YupHio/LEaD_Design/README.md

# Wiki Page
View our Wiki page at this URL: http://mindworks.shoutwiki.com/wiki/Wireless_Tower_of_Lights

# LEaD_Design
Wireless Tower Lights Project for Senior Capstone Design

### Teammates:
- Adrian Beehner
- Kevin Dorscher
- Andrew Butler
- Paul Martin
