YupHio/LEaD_Design/Doc/Meetings/Meeting_Notes/3-23 Meeting Notes.docx

3/23/18 Client Meeting Notes

Meeting started at 3:49, all team members except Adrian present. Adrian had an emergency and wouldn’t be available until 5 at the earliest.

What number of light bars are required? Prof. Rinker doesn’t care, he suggests that we have enough to put on a little show at expo. At least 4. Volunteers could manufacture the rest after this semester.

Rinker suggests adding a resistor to each set of LEDs, rather than having one for both sets in parallel. Another option would be to adjust the existing resistor value, but that will tie the circuits together meaning that a failure would affect all the other LEDs, rather than just the others in the string. That might not cause damage though, we should test a breech in one side of the circuit.

Wire management: trim what we have, minimize slack, use electrical tape to keep nice and out of the way.

Rinker’s going to send us the Goofy Glasses code for the PC and the Arduino once he can find it on his PC. We have battery chargers, receivers, and resistors. We just need the ZIF socket to program Arduino chips and then we should be good to go. Rinker will be putting that in his mailbox sometime this weekend.

Meeting ended at 4:30
