YupHio/LEaD_Design/Doc/Snapshot_Day_3/Documentation of Design-Proof of Design.pdf

## Documentation of Design

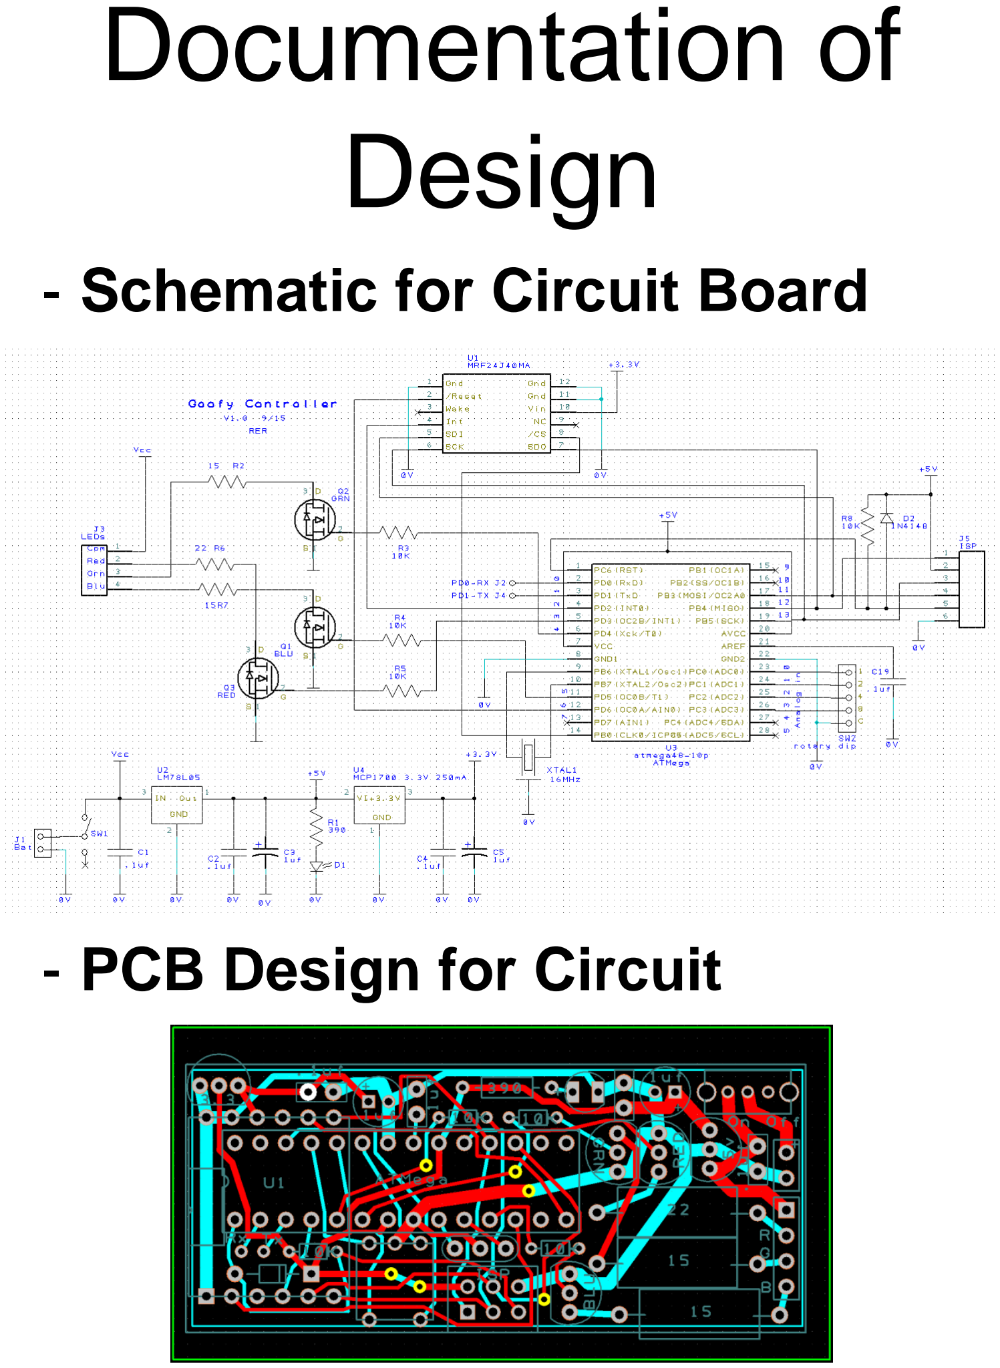
[picture p35: page 1]

- Schematic for Circuit Board
- PCB Design for Circuit

- LightBar
- Lightbar designed similar to original Tower of Lights one

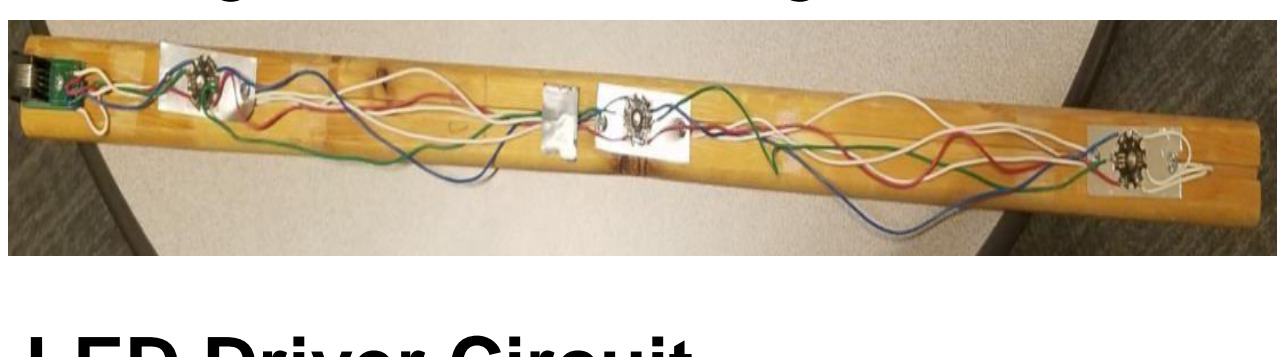
[picture p36: figure]

- LED Driver Circuit
- Similar to Goofy Glasses circuit (top), ours (bottom)

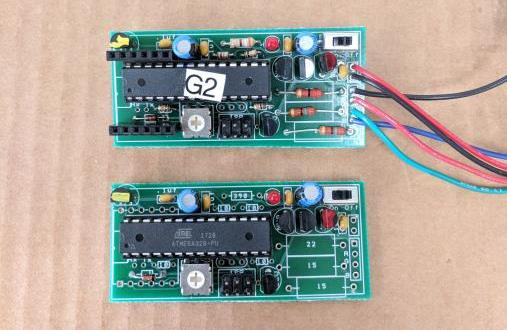
[picture p37: figure]

- Towerplayer program
- Modifed towerarduino.ino, towerplayer.cpp

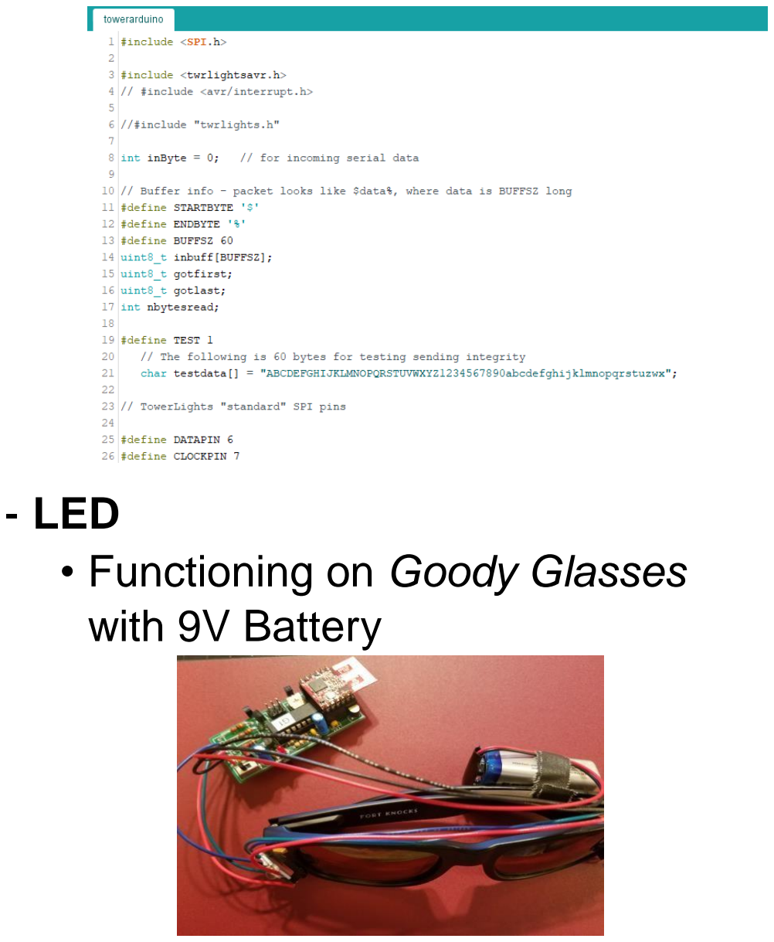
[picture p38: page 3]

- LED
- Functioning on Goody Glasses with 9V Battery

Data Sheets:
- Xbee Transmitter

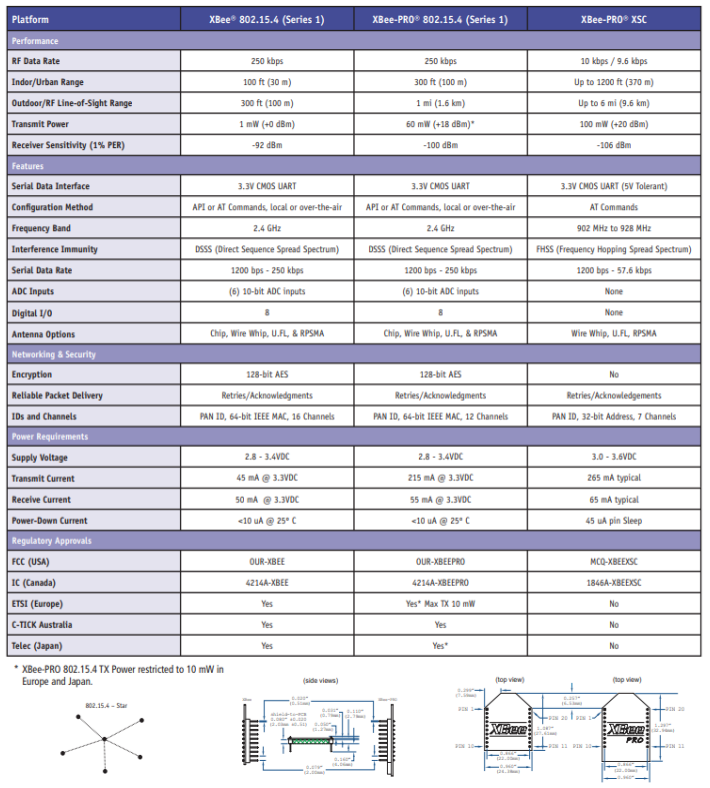
[picture p39: figure]

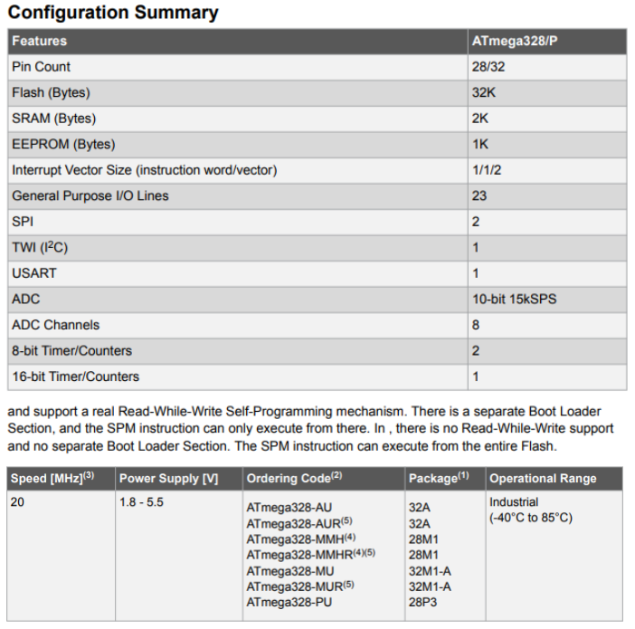
[picture p40: figure]

- Atmega 328P

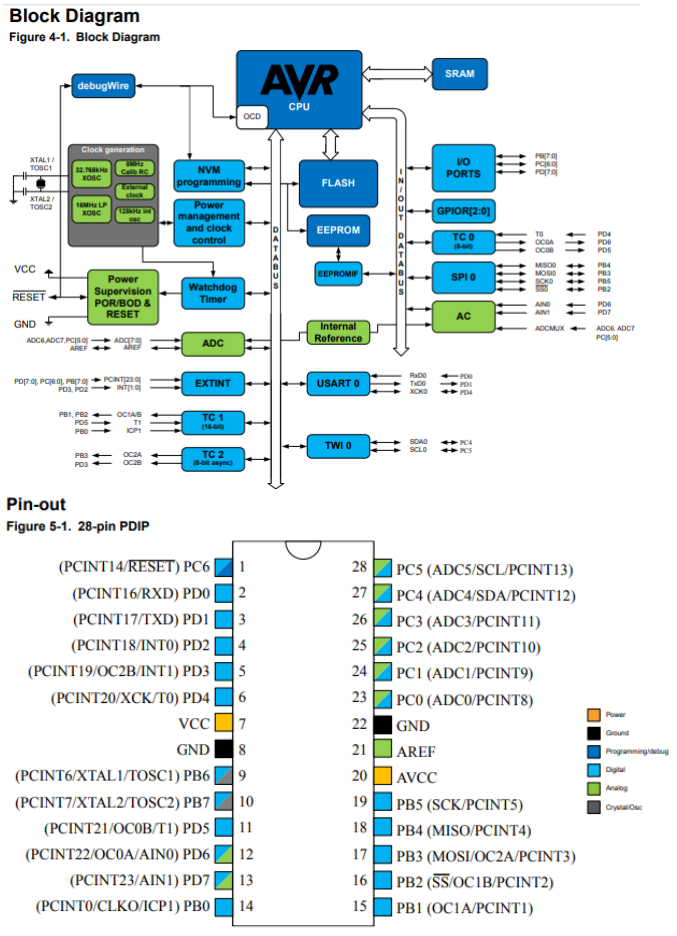
[picture p41: figure]

- Xbee Sheild

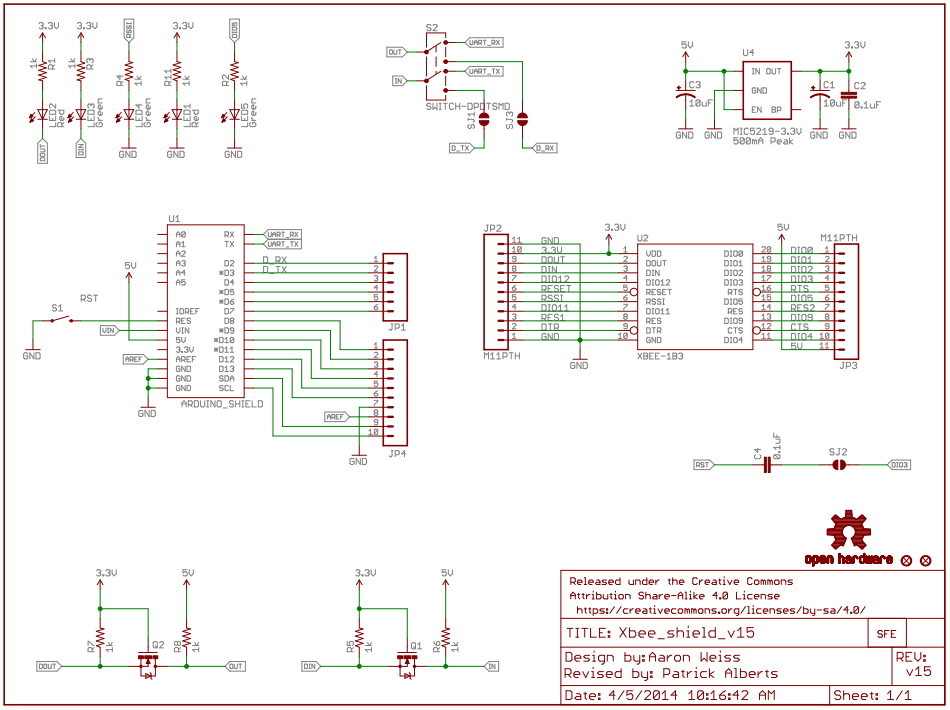
[picture p42: figure]

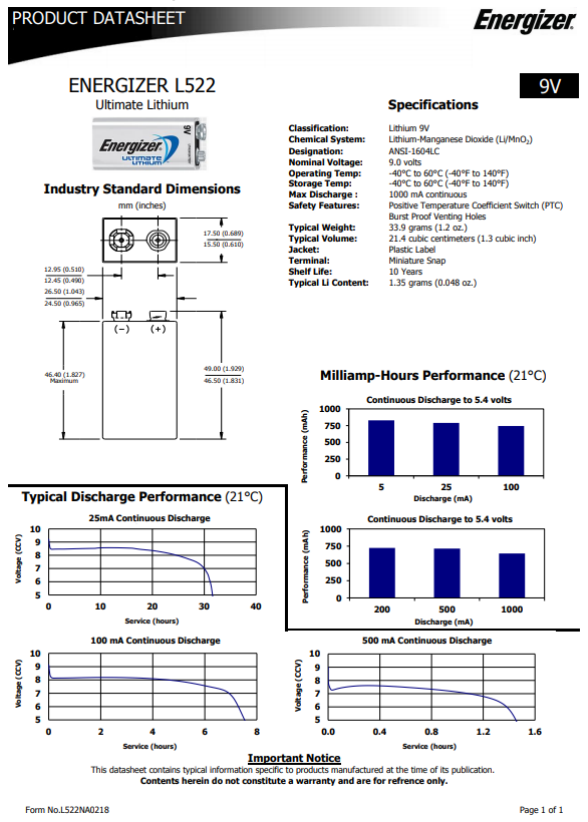
[picture p43: figure]

- 9V Battery
