YupHio/LEaD_Design/Doc/Snapshot_Day_2/Proof_Of_Design.pdf

## Proof of Design

- LightBar
- Lightbar designed similar to original Tower of Lights one

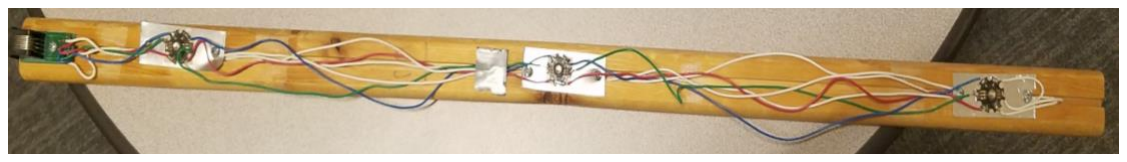
[picture p53: figure]

- LED Driver Circuit
- Similar to Goofy
Glasses circuit,
similar schematic

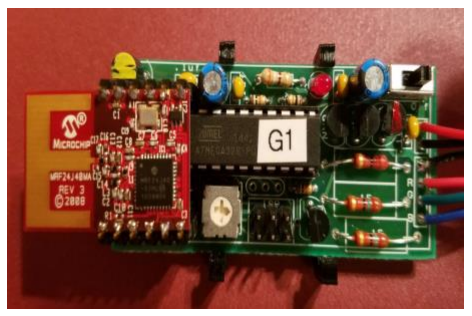
[picture p54: figure]

- Towerplayer program
- Modifed towerarduino.ino, towerplayer.cpp
- LED
- Functioning on
Goody Glasses
with 9V Battery

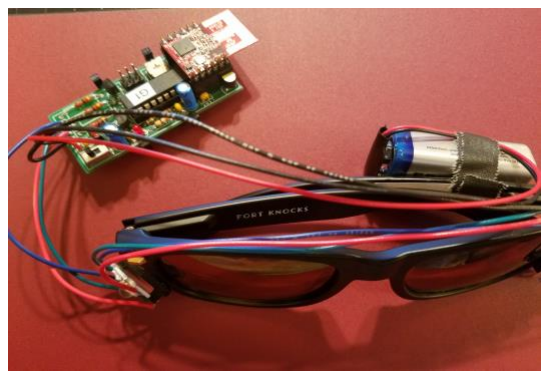
[picture p55: figure]
