YupHio/LEaD_Design/Doc/Expo/Expo_Presentation.pdf

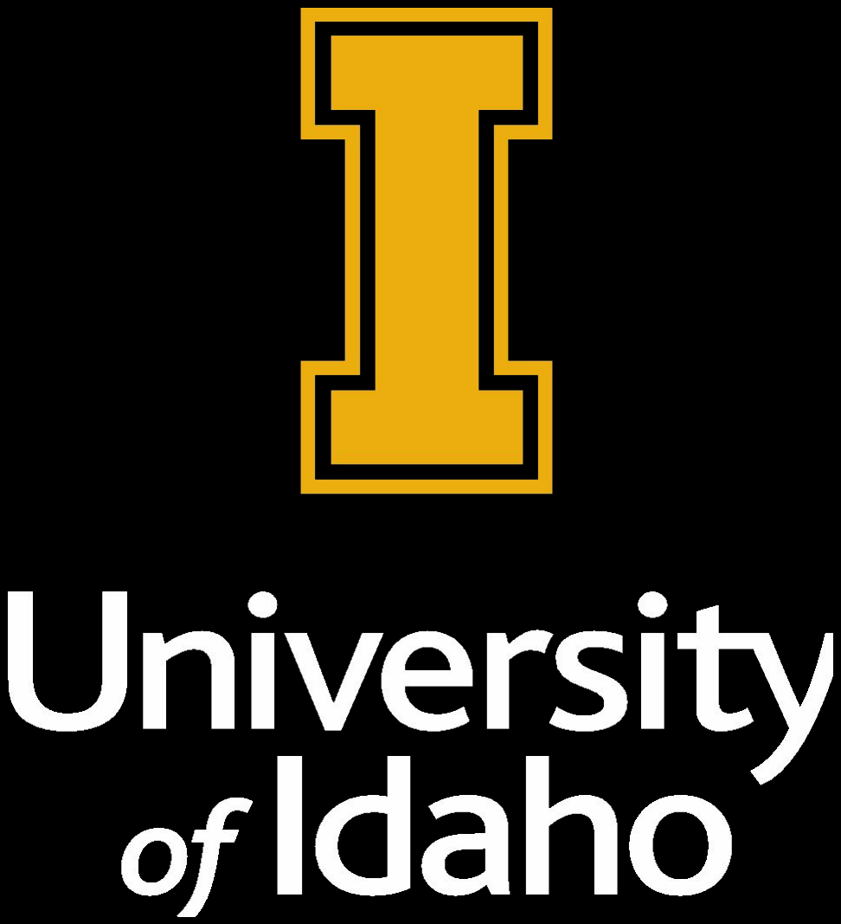
[picture p56: figure]

## Wireless Tower Lights

By: LEaD Design
Adrian Beehner, Andrew Butler, Kevin Dorscher, and Paul Martin

## Team Members

- Adrian Beehner: “Adrian is a remote student, this can introduce unique challenges. He directs the budget for our project.”
- Andrew Butler: “Andrew is in charge of documentation for the project.”
- Kevin Dorscher: “Kevin is the client liaison and organizes team meetings”
- Paul Martin: “Paul is the team's Wiki-master and designer”
- Wiki: http://mindworks.shoutwiki.com/wiki/Wireless_Tower_of_Lights

## Tower Lights Background

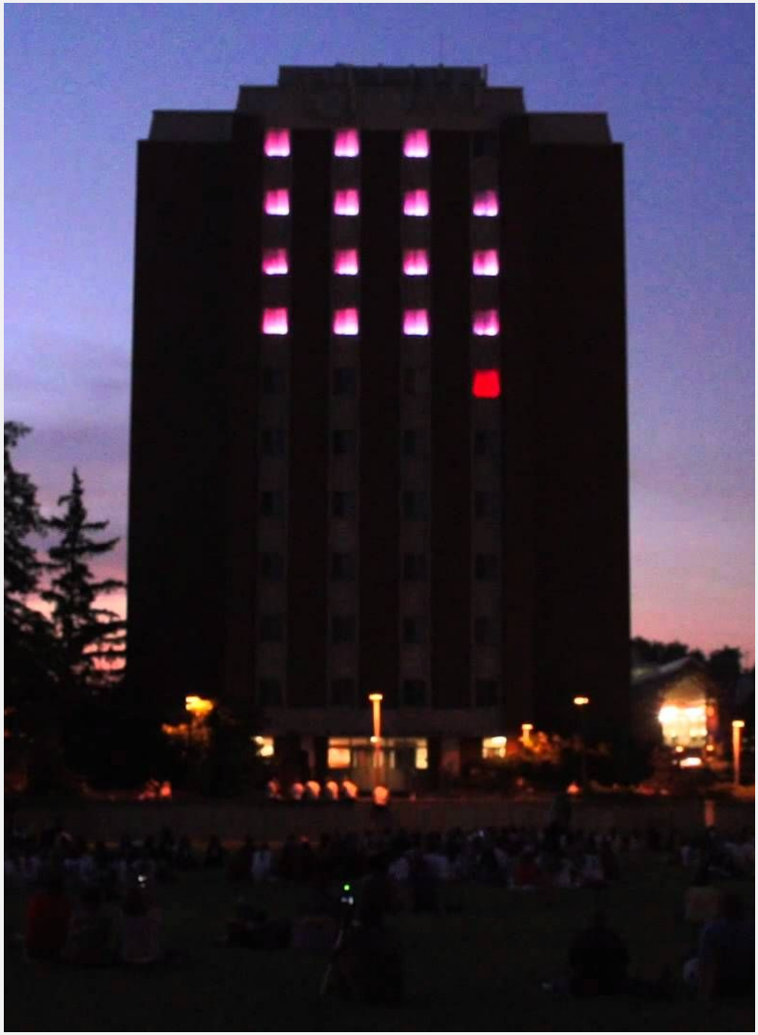
[picture p57: figure]

- Ongoing project to convert to a fully wireless system
- The Tower Lights show is displayed on the south side of Theophilus Tower
- Each window has LED lights which illuminate in sync to music

## Project Information

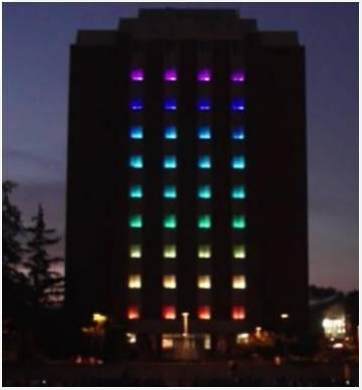
[picture p58: figure]
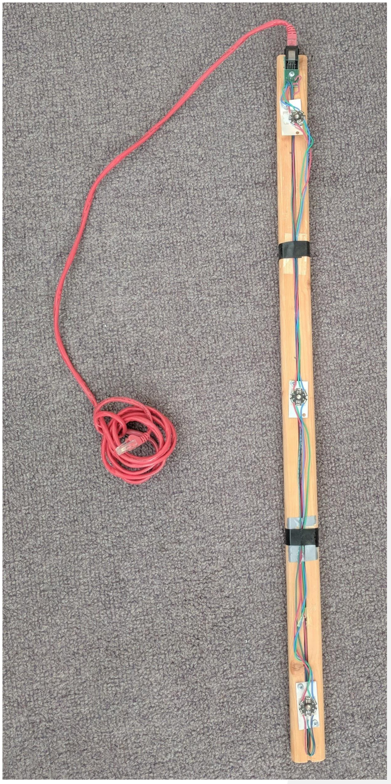
[picture p59: figure]

- The old system relies on CAT-5 wiring from basement up to every room
- New system will not rely on wires
- Thus Light show could be used in any building
- Interest in using the system in buildings in Coeur d'Alene, Idaho
Light Bar | Lit Up Tower

## Problem Statement

### - The University of Idaho’s Tower Lights system currently runs on old unused Ethernet wiring in the Theophilus Tower

### - Our team is faced with the problem of turning the current Tower Lights control system into a battery powered wireless system

## Project Requirements Flow Chart

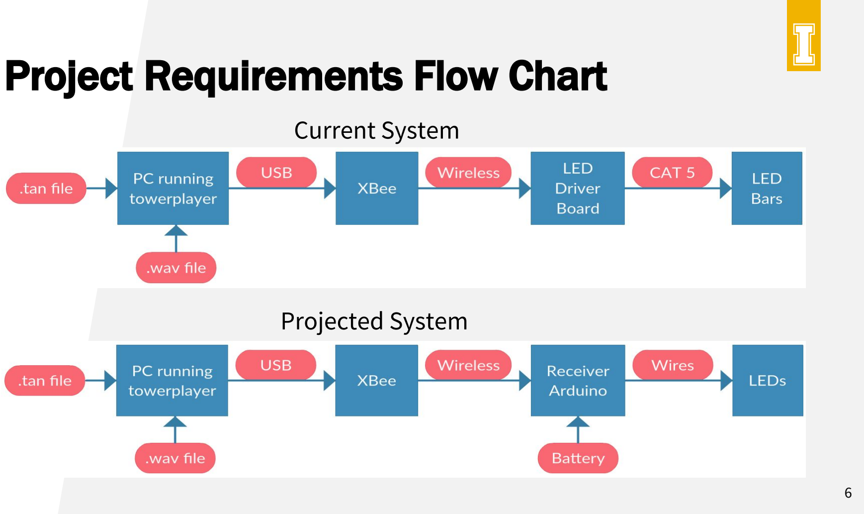
[picture p60: page 6]

Current System

Projected System

## Project Problems/Solutions

- Problem: Identify a wireless protocol to have an effective range of potentially up to 100 meters
- Solution: Utilize the 802.15.4 protocol
- Problem: Frequency must be one that will work even in crowded venues, with lots of different cellphones, and Wi-Fi signals present
- Solution: We are using channels 25 and 26, which are above Wi-Fi range.

## Project Problems/Solutions

- Problem: Our wireless protocol can only send 250 kbits/s. If we have enough light bars in a large building, we may run out of bandwidth
- Solution: Change quality of the RGB color send to each light bar, instead of sending 24bit Truecolor RGB with 16 million possible colors, send 12bit RGB and have 4,096 possible colors.

## Design Specifications Introduction

### - Battery Specification - LED Specification - Arduino / Receiver Specification - Wireless Specification

## Battery Specifications

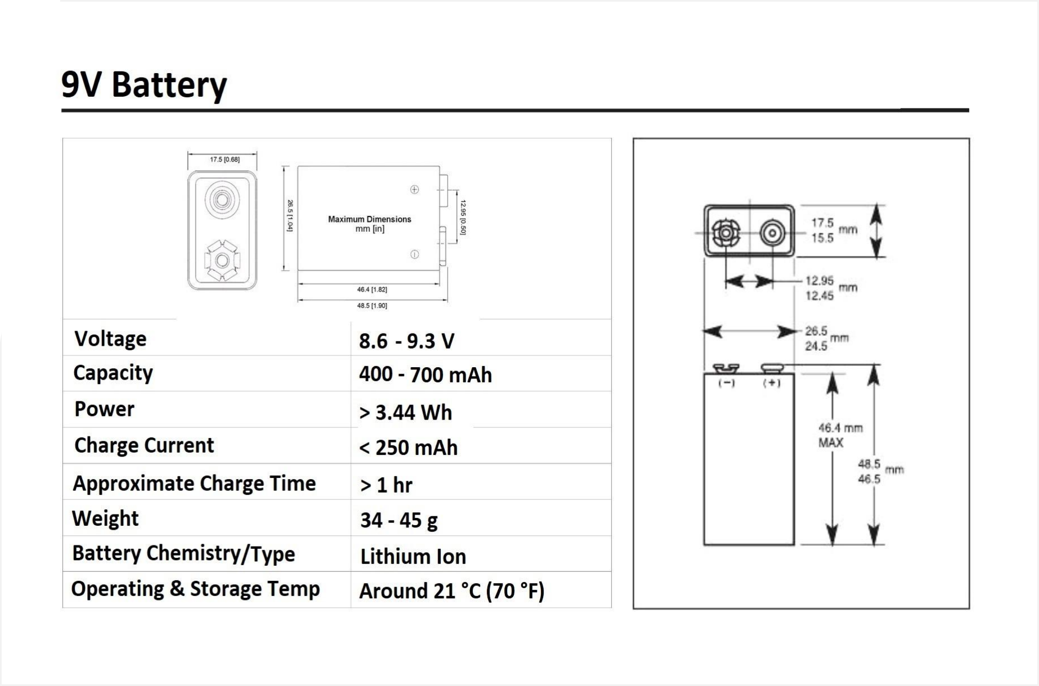
[picture p61: figure]

## LED Specifications

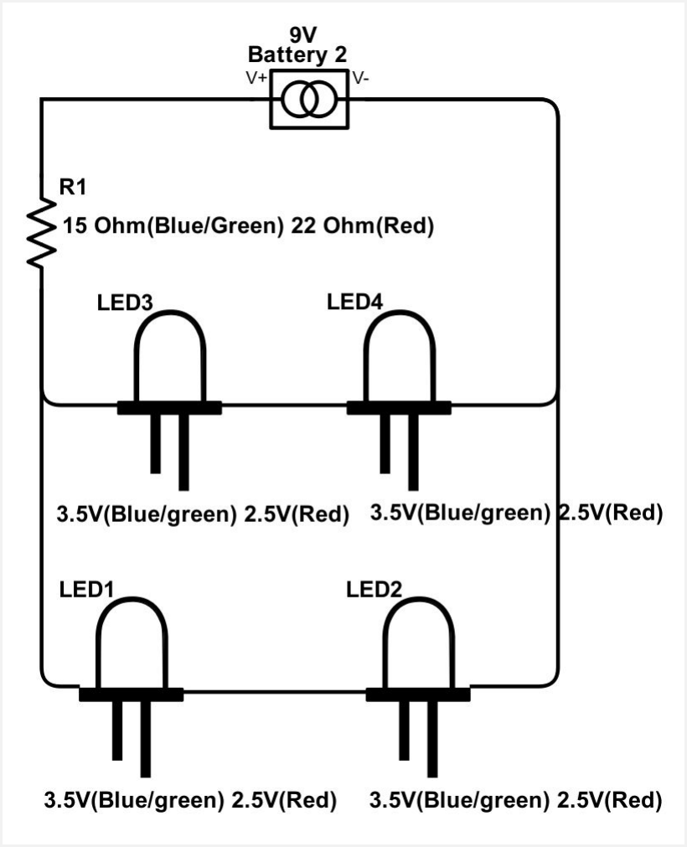
[picture p62: figure]

## Wireless Specification

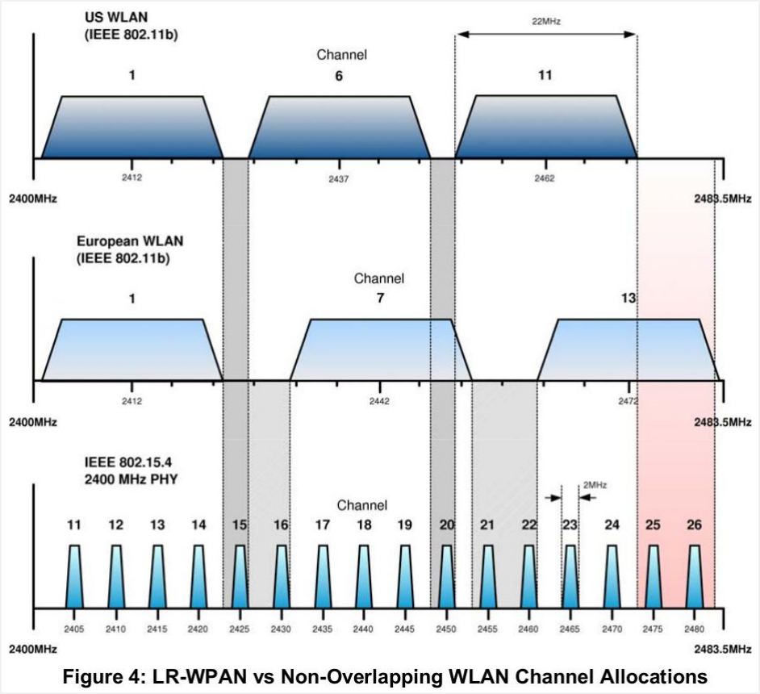
[picture p63: figure]

## Deliverables

### - LEaD Design Wiki Page - LEaD Design Team Portfolio - Wireless Light Bars

Project Learning ● Battery Component ● LED Component ● Arduino / Receiver Component ● Wireless Component ● Code Additions ○ Sleep / Wake Mode ○ 40+ Channel Support

## Design Choices Introduction

### - Resistors for Voltage Adjustment - Two Sets of Two LED’s in Series - Single 9v Lithium Ion Battery

## Resistors Instead of Specialized Circuitry

### - Decreased Cost Short-Term - Integrated Into a Single Circuit - Smaller Time Investment Short-Term - Optimal Solution

## 9v Li Battery

### - Readily Available - Increased Reliability - Rechargeable - Decreased Cost Short-Term - Capacity Fits Needs

## LightBar CAD Prototype Model

- Rendering of Light Bar, batteries and wireless receiver mounted on top

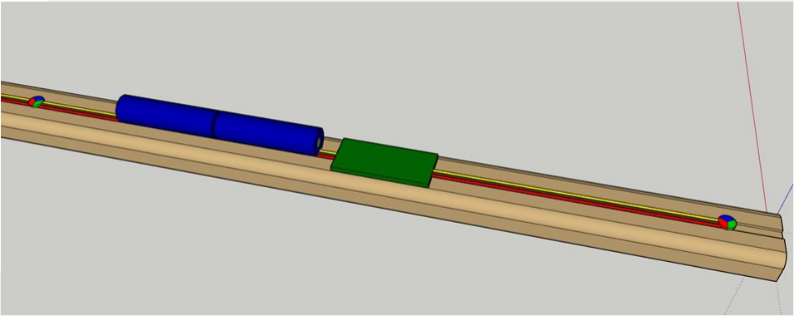
[picture p64: figure]

## Schematic for Circuit Board

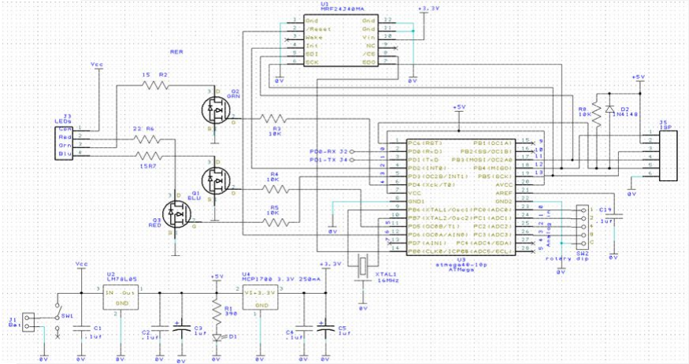
[picture p65: figure]

## Circuit Board

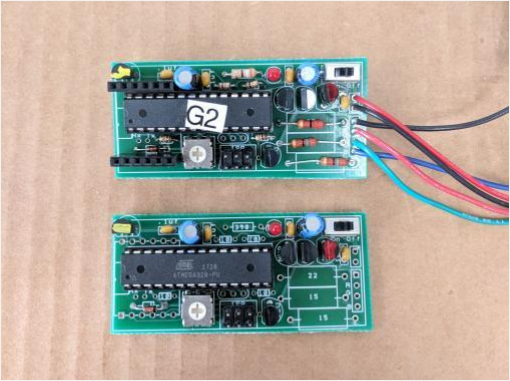
[picture p66: figure]

## Final Prototype

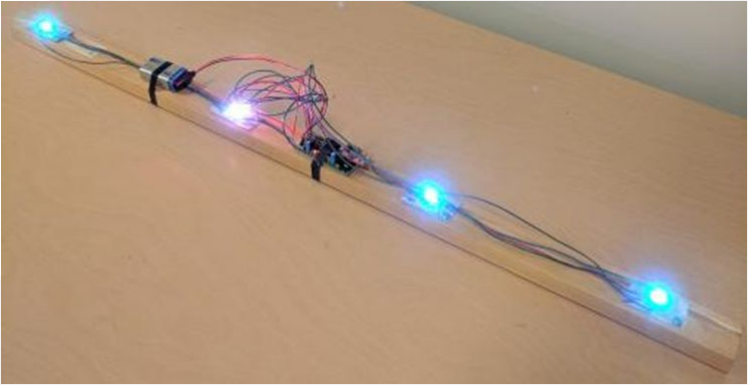
[picture p67: figure]

## Budget / Cost

Budget
- Approx. $30 per light bar
- Approx. $3000 total budget
- 4 prototypes created

Cost
- Atmega 328P Chip - $2.00~$6.00
- MRF Receiver Chip - $6.00~$9.00
- 9V Battery - $7.00~$12.00
- RGB LED - $2.00
- LED Driver Circuits - $33.00 60 in ² board
- 1 in x 2 in Board - $1.00~$10.00

## Budget / Cost

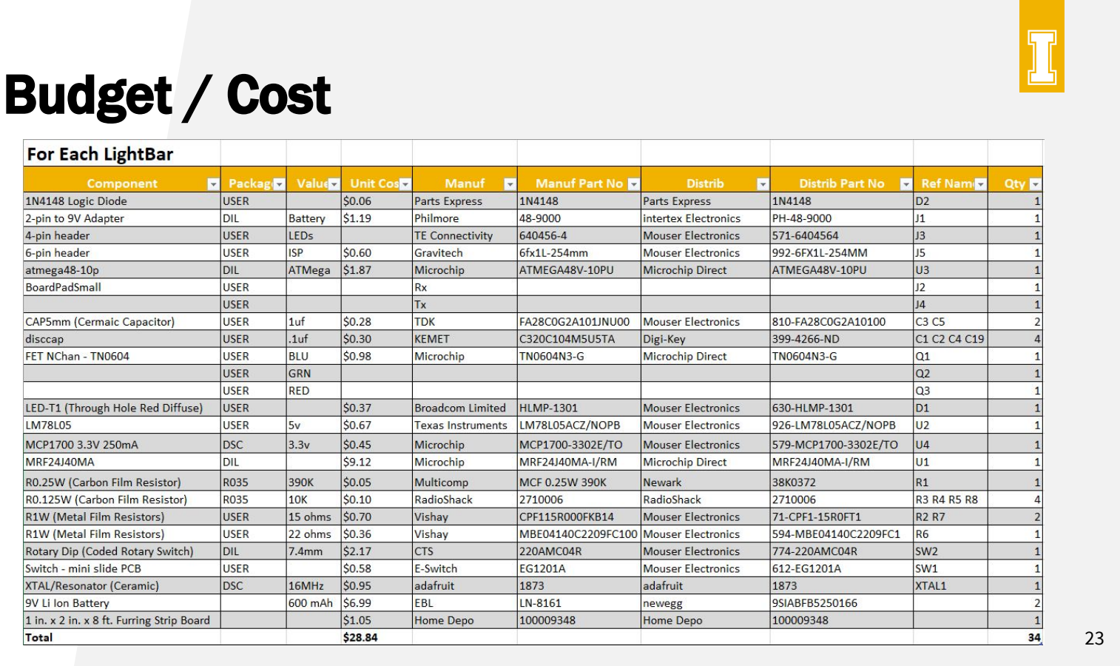
[picture p68: page 23]

## Schedule

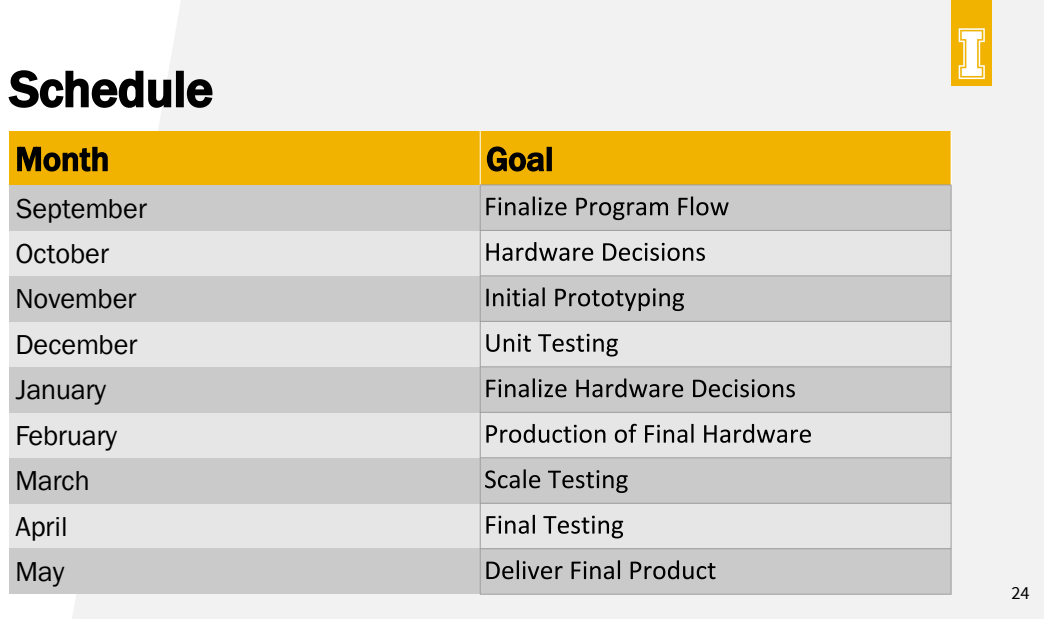
[picture p69: page 24]

Month | Goal

September
October
November
December
January
February
March
April
May

## Client Needs

### - Wireless / Portable - Low Power Consumption - Visibility of LED’s - 40+ Light Bars Supported by Code Base

## Conclusion

### - We are interested in any questions, confusions, or input you may have!

### Thank You for Listening!

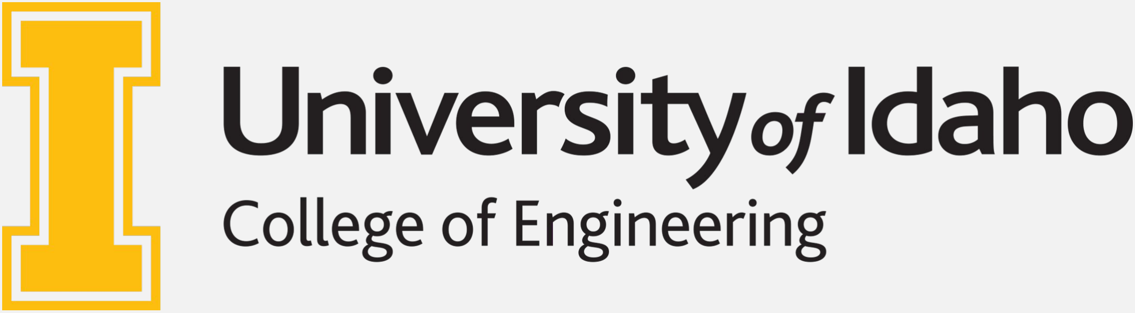
[picture p70: figure]
