YupHio/LEaD_Design/Doc/Snapshot_Day_3/Project Completion.pdf

# Project Completion

March | Prototype Testing Final Hardware Creation Software Updates
April | Scale Testing Product Revisions Final Testing
May | Deliver Final Product
