YupHio/LEaD_Design/Doc/Snapshot_Day_3/Project_Learning.pdf

# Project Learning

- Wireless Transmission
- Frequency
- Packet Size/Encoding
- Processor Sleep Modes
- Power Usage
- Waking Remotely
- Battery Chosen
- Chemistry
- Voltage and Capacity
- Circuit Design and Creation
- Component Decisions
- Software Usage
- Soldering
