YupHio/LEaD_Design/Doc/Snapshot_Day_3/Team_Info.pdf

# LEaD Design

Adrian Beehner
Andrew Butler
Kevin Dorscher
Paul Martin

UI CS – Wireless Tower of Lights

Sponsor – Dr. Robert Rinker

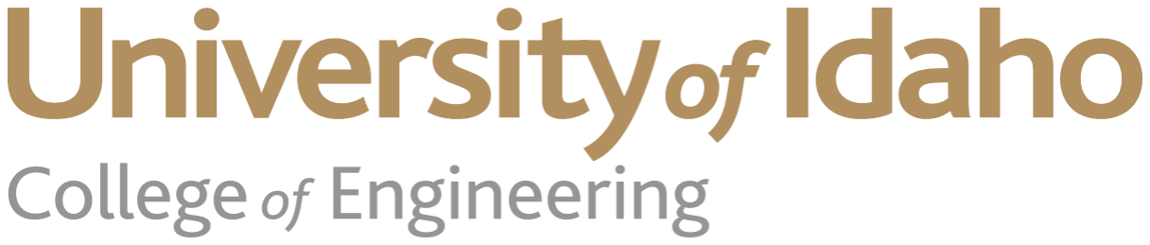
[picture p71: figure]
