YupHio/LEaD_Design/Doc/Snapshot_Day_3/6_VisionOfFinalProduct.pdf

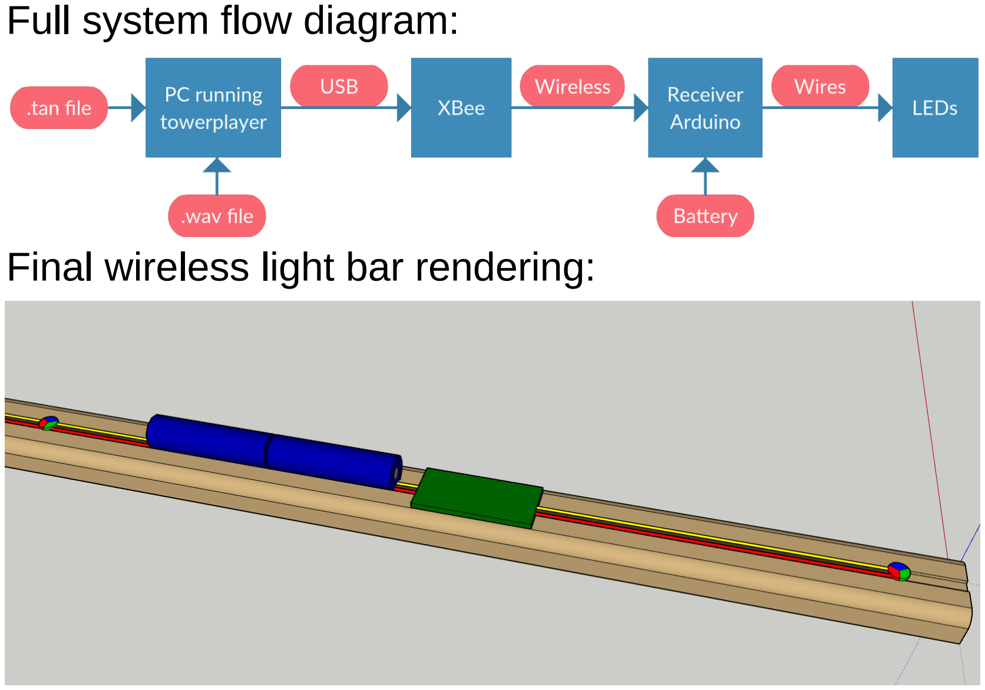
[picture p72: page 1]

Full system flow diagram:

Final wireless light bar rendering:
