YupHio/LEaD_Design/Resources/Info/zigbee-vs-wifi.pdf

Jennic | Co-existence of IEEE 802.15.4 at 2.4 GHz

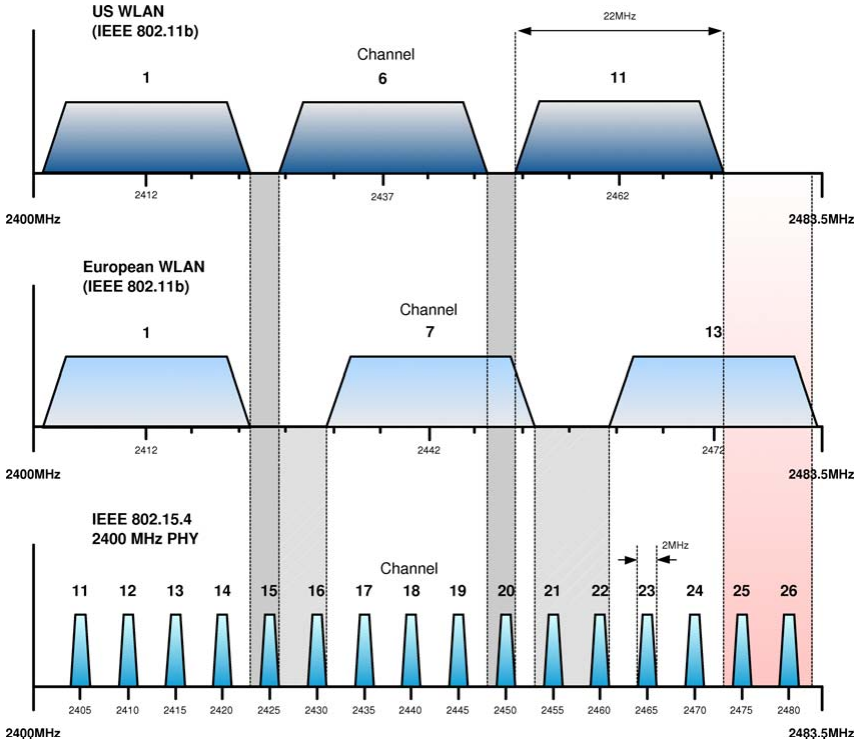
[picture p73: figure]

Figure 4: LR-WPAN vs Non-Overlapping WLAN Channel Allocations

14 | © Jennic 2008 | JN-AN-1079 v1.0
