YupHio/LEaD_Design/Doc/Snapshot_Day_2/7_IssuesAndPlans.pdf

Unresolved Issues and Plans

- Issue: Exact battery selection and design is not yet solidified.
Plan: Test a couple different battery options once we have completed the rest of the project. Torture/time test each option.
- Issue: Our wireless protocol can only send 250kbits/s. If we have enough light bars in a large building, we may run out of bandwidth.
Plan: We can change the quality of the RGB color sent to each light bar. For example instead of sending 24bit Truecolor RGB with 16 million possible colors, we could send 12bit RGB and have only 4,096 possible colors.
