YupHio/LEaD_Design/Resources/Debugging/need_a_tan.png

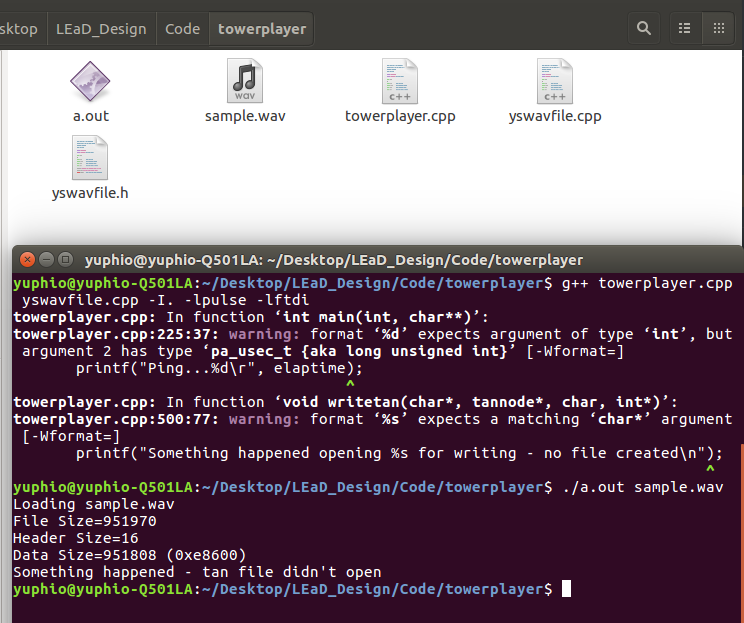
Resources/Debugging/need_a_tan.png
