YupHio/LEaD_Design/Resources/Debugging/Working_9-22.png

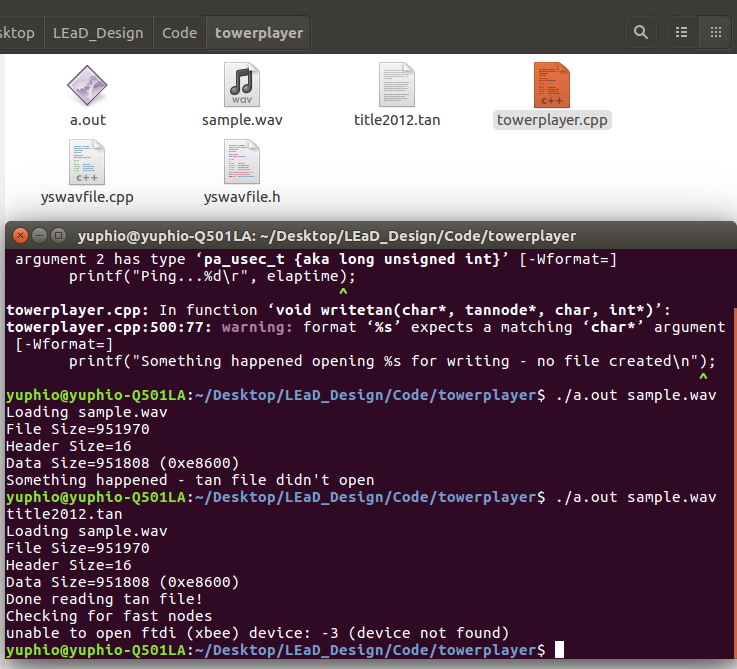
Resources/Debugging/Working_9-22.png
