YupHio/LEaD_Design/Doc/Expo/Expo_Poster_Final.pdf

# Wireless Tower of Lights

## ADD TEXT AND VISUALS Problem

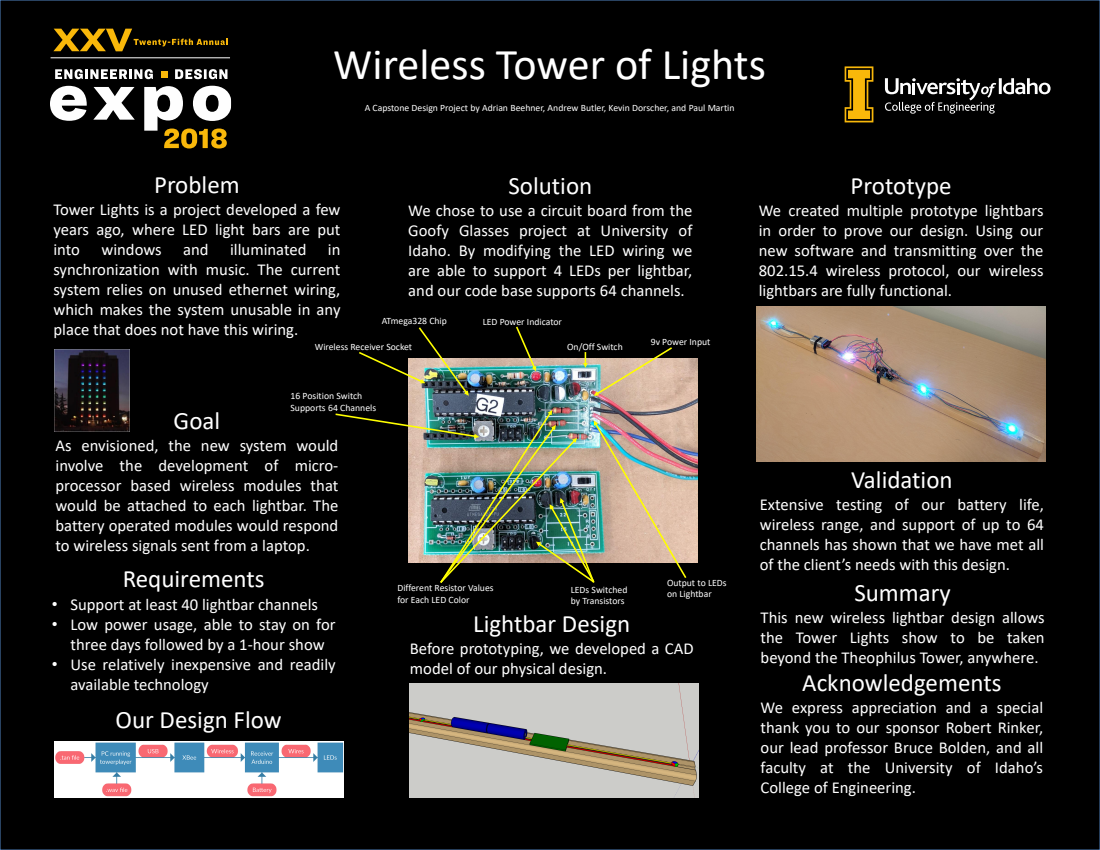
[picture p78: page 1]
into; windows; and; illuminated; Goal; Solution; Lightbar Design; Prototype; Validation; Summary; ATmega328 Chip; 9v Power Input; LEDs Switched by Transistors; 16 Position Switch Supports 64 Channels

A Capstone Design Project by Adrian Beehner, Andrew Butler, Kevin Dorscher, and Paul Martin

Tower Lights is a project developed a few
years ago, where LED light bars are put
synchronization with music. The current
system relies on unused ethernet wiring,
which makes the system unusable in any
place that does not have this wiring.

We chose to use a circuit board from the
Goofy Glasses project at University of
Idaho. By modifying the LED wiring we
are able to support 4 LEDs per lightbar,
and our code base supports 64 channels.

We created multiple prototype lightbars
in order to prove our design. Using our
new software and transmitting over the
802.15.4 wireless protocol, our wireless
lightbars are fully functional.

LED Power Indicator

Wireless Receiver Socket

On/Off Switch

As envisioned, the new system would
involve the development of micro-
processor based wireless modules that
would be attached to each lightbar. The
battery operated modules would respond
to wireless signals sent from a laptop.
Requirements

Extensive testing of our battery life,
wireless range, and support of up to 64
channels has shown that we have met all
of the client’s needs with this design.

Output to LEDs
on Lightbar

Different Resistor Values
for Each LED Color

• Support at least 40 lightbar channels
• Low power usage, able to stay on for
three days followed by a 1-hour show
• Use relatively inexpensive and readily
available technology
Our Design Flow

This new wireless lightbar design allows
the Tower Lights show to be taken
beyond the Theophilus Tower, anywhere.
Acknowledgements
We express appreciation and a special
thank you to our sponsor Robert Rinker,
our lead professor Bruce Bolden, and all
faculty at the University of Idaho’s
College of Engineering.

Before prototyping, we developed a CAD
model of our physical design.
