YupHio/LEaD_Design/Code/goofyglasses/uiGCdemo/uiGCdemo.ino

#include <SoftPWM_timer.h>
#include <SoftPWM.h>

#include "mrf24j.h"
#include <SPI.h>

/*
* uiGC0 
* Goofy Controller 0
* common cathode LEDs +
* Mrf24j40
* 
* Benjamin Jeffery
* University of Idaho
* 10/09/2015
* 
*/

int redPin = 3;
int greenPin = 4;
int bluePin = 5;
int pin_reset = 6;
int pin_cs = 8;
int pin_interrupt = 2;
int idVal;
int startId;

Mrf24j mrf(pin_reset, pin_cs, pin_interrupt);

void setup() {
  DDRC = 0x00;
  SoftPWMBegin();
  SoftPWMSet(redPin, 0);
  SoftPWMSet(greenPin, 0);
  pinMode(bluePin, OUTPUT);
  SoftPWMSetFadeTime(redPin, 100, 100);
  SoftPWMSetFadeTime(greenPin, 100, 100);
  
  digitalWrite(A0,HIGH);
  digitalWrite(A1, HIGH);
  digitalWrite(A2, HIGH);
  digitalWrite(A3, HIGH);

  setColor(0,0,0);
  
  mrf.reset();
  mrf.init();
  mrf.set_pan(2015);
  mrf.set_channel(0x0C);
  mrf.address16_write(0x4202);
  mrf.set_promiscuous(true);
  mrf.set_bufferPHY(true);
  
  attachInterrupt(0, interrupt_routine, CHANGE);
  interrupts();
  idVal = ~PINC & 0x0f;
  startId = idVal * 3;
}

void interrupt_routine()
{
  mrf.interrupt_handler();
}

void loop()
{
  if (idVal == 15) 
  {
    setColor(255, 0, 0);
    delay(250);
    setColor(0,0,0);
    delay(45);
    setColor(0, 255, 0);
    delay(250);
    setColor(0,0,0);
    delay(45);
    setColor(0, 0, 255);
    delay(250);
    setColor(0,0,0);
    delay(45);
    setColor(255,215,0);
    delay(250);
    setColor(0,0,0);
    delay(50);
    setColor(255,255,215);
    delay(250);
    setColor(0,0,0);
    delay(50);
  }
  else {
    mrf.check_flags(&handle_rx, &handle_tx); 
  }
}

void handle_rx()
{
  setColor(mrf.get_rxinfo()->rx_data[startId],mrf.get_rxinfo()->rx_data[startId+1],mrf.get_rxinfo()->rx_data[startId+2]);
  mrf.rx_flush();
}

void handle_tx()
{
}

void setColor(int red, int green, int blue)
{
  SoftPWMSet(redPin, red);
  SoftPWMSet(greenPin, green);
  analogWrite(bluePin, blue);
}
