YupHio/LEaD_Design/(commit log)

2017-09-21 Create Folder Team Contract
    Also create/insert beginning file structure for contract
2017-09-22 Sample .wav file added for testing
2017-09-22 Working with sample .tan file
2017-10-03 We can print this... lol
2017-10-04 Increased font size in flow diagrams
2017-10-04 Final Team Portfolio for Printing
2017-10-10 Added Arduino / Receiver Specifications
    Snapshot Day #1
2017-10-10 Arduino / Receiver Specifications
2017-10-10 Battery Specification
2017-10-10 Adding LED doc
2017-11-05 Team Portfolio Update
    Added Arduino_Receiver_Diagram.png to Doc/Portfolio/assets folder.
    Added Arduino / Receiver Design Specification to the Specifications and Constraints section.
    Removed The "Meeting Minutes" section in the portfolio documentation and created 2 new sections:
    "Team Meetings and Minutes"
    "Client Meetings and Minutes"
    Still need to fill out some of the Team Meeting Notes and Client Meeting Notes subsections, will push again later, after these additions.
2017-11-06 Added Battery Design Specification
2017-11-06 Finished Arduino / Receiver Design Spedification
2017-11-06 Fixed an error in Arduino / Receiver Spec.
    I also deleted a temp file that I mistakenly uploaded.
2017-11-06 Adding LED specifications to portfolio
2017-11-06 Added Wireless Spec to portfolio
2018-02-13 Added Bill of Materials
    pdf and xlsx formats
    [Bill_of_Materials.xlsx]
2018-03-04 Added bill of materials, more battery info, and DFMEA
2018-05-02 Better timer duration!
2018-05-03 avoid entering command mode just in case
    [wirelessTower0.ino, wirelessTower1.ino, wirelessTower2.ino, wirelessTower3.ino, wirelessTowerDemo.ino]
2018-05-04 Adding circuit diagram and code link to design report
2018-05-04 Added Senior Expo Section and circuit diagram
